Nordic-Energy/HalfBridgePowerModule/mechanical/3D view.PNG

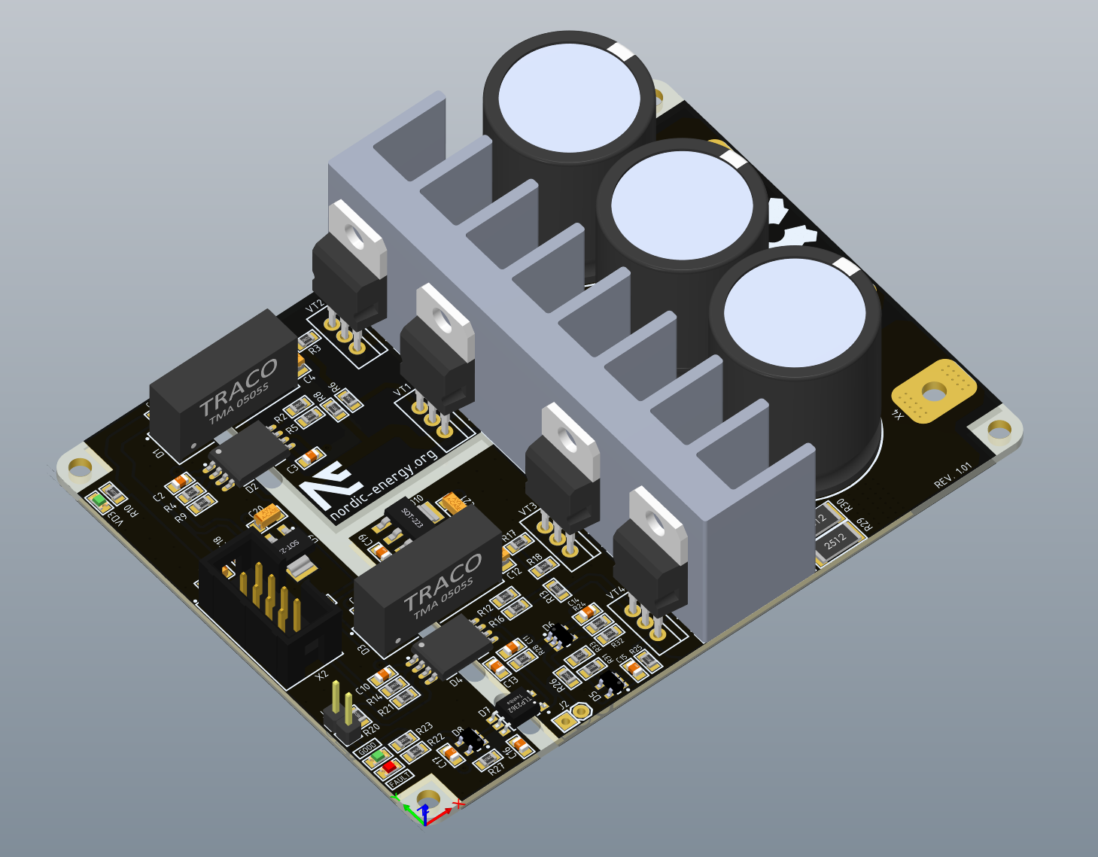
mechanical/3D view.PNG
