Nordic-Energy/HalfBridgePowerModule/docs/BOM for half-brudge module.xlsx

Value | Designator | Manufacturer | Model | Quantity
1μF | C1, C3, C6, C11, C18, C19 | Yageo | CC0805KKX7R7BB105 | 6
0.1μF | C2, C10, C14, C16, C17 | Yageo | CC0805KRX7R7BB104 | 5
4.7μF | C4, C5, C12 | KEMET | T494A475M025AT | 3
680μF | C7, C8, C9 | Yageo | LG100M0680BPF-2225 | 3
100pF | C13, C15 | Yageo | CC0805KRNPO9BN101 | 2
33μF | C20, C21 | AVX | TPSA336K010R0700 | 2
 | D1, D3 | Mornsun | B1212S-2W | 2
 | D2, D4 | Infineon | 1EDC60I12AHXUMA1 | 2
 | D5 | Texas Instruments | LMV611MFX/NOPB | 1
 | D6 | Texas Instruments | TLV3491AIDBVR | 1
 | D7 | Toshiba | TLP2362 | 1
 | D8 | Texas Instruments | SN74LVC1G14DBVRG4 | 1
 | D9 | Diodes | AZ1117IH-3.3TRG1 | 1
 | D10 | Diodes | AZ1117IH-5.0TRG1 | 1
 | J1, J2 | Connfly | PLS-2 | 2
10k | R1, R8, R9, R10, R11, R18, R20, R21 | Yageo | RC0805JR-0710KL | 8
1R | R2, R3, R6, R12, R13, R17 | Yageo | RC0805JR-071RL | 6
100R | R4, R7, R14, R26, R28 | Yageo | RC0805JR-07100RL | 5
1R8 | R5, R16 | Yageo | RC0805JR-071R8L | 2
100k | R15, R19 | Yageo | RC1206JR-07100KL | 2
1k | R22, R23, R25 | Yageo | RC0805JR-071KL | 3
1k | R24, R33 | Yageo | RC0805FR-071KL | 2
4k7 | R27 | Yageo | RC0805JR-074K7L | 1
0R004 | R29, R30 | Yageo | PA2512FKF7W0R004E | 2
100k | R31 | Yageo | RC0805FR-07100KL | 1
10k | R32 | Yageo | RC0805FR-0710KL | 1
 | VD1, VD2, VD3, VD5 | Wurth | 150080VS75000 | 4
 | VD4 | Wurth | 150080RS75000 | 1
 | VT1, VT2, VT3, VT4 | Infineon | IPP083N10N5AKSA1 | 4
 | X2 | Connfly | IDC-10M | 1
