Nordic-Energy/HalfBridgePowerModule/docs/Schematics for half-bridge module.pdf

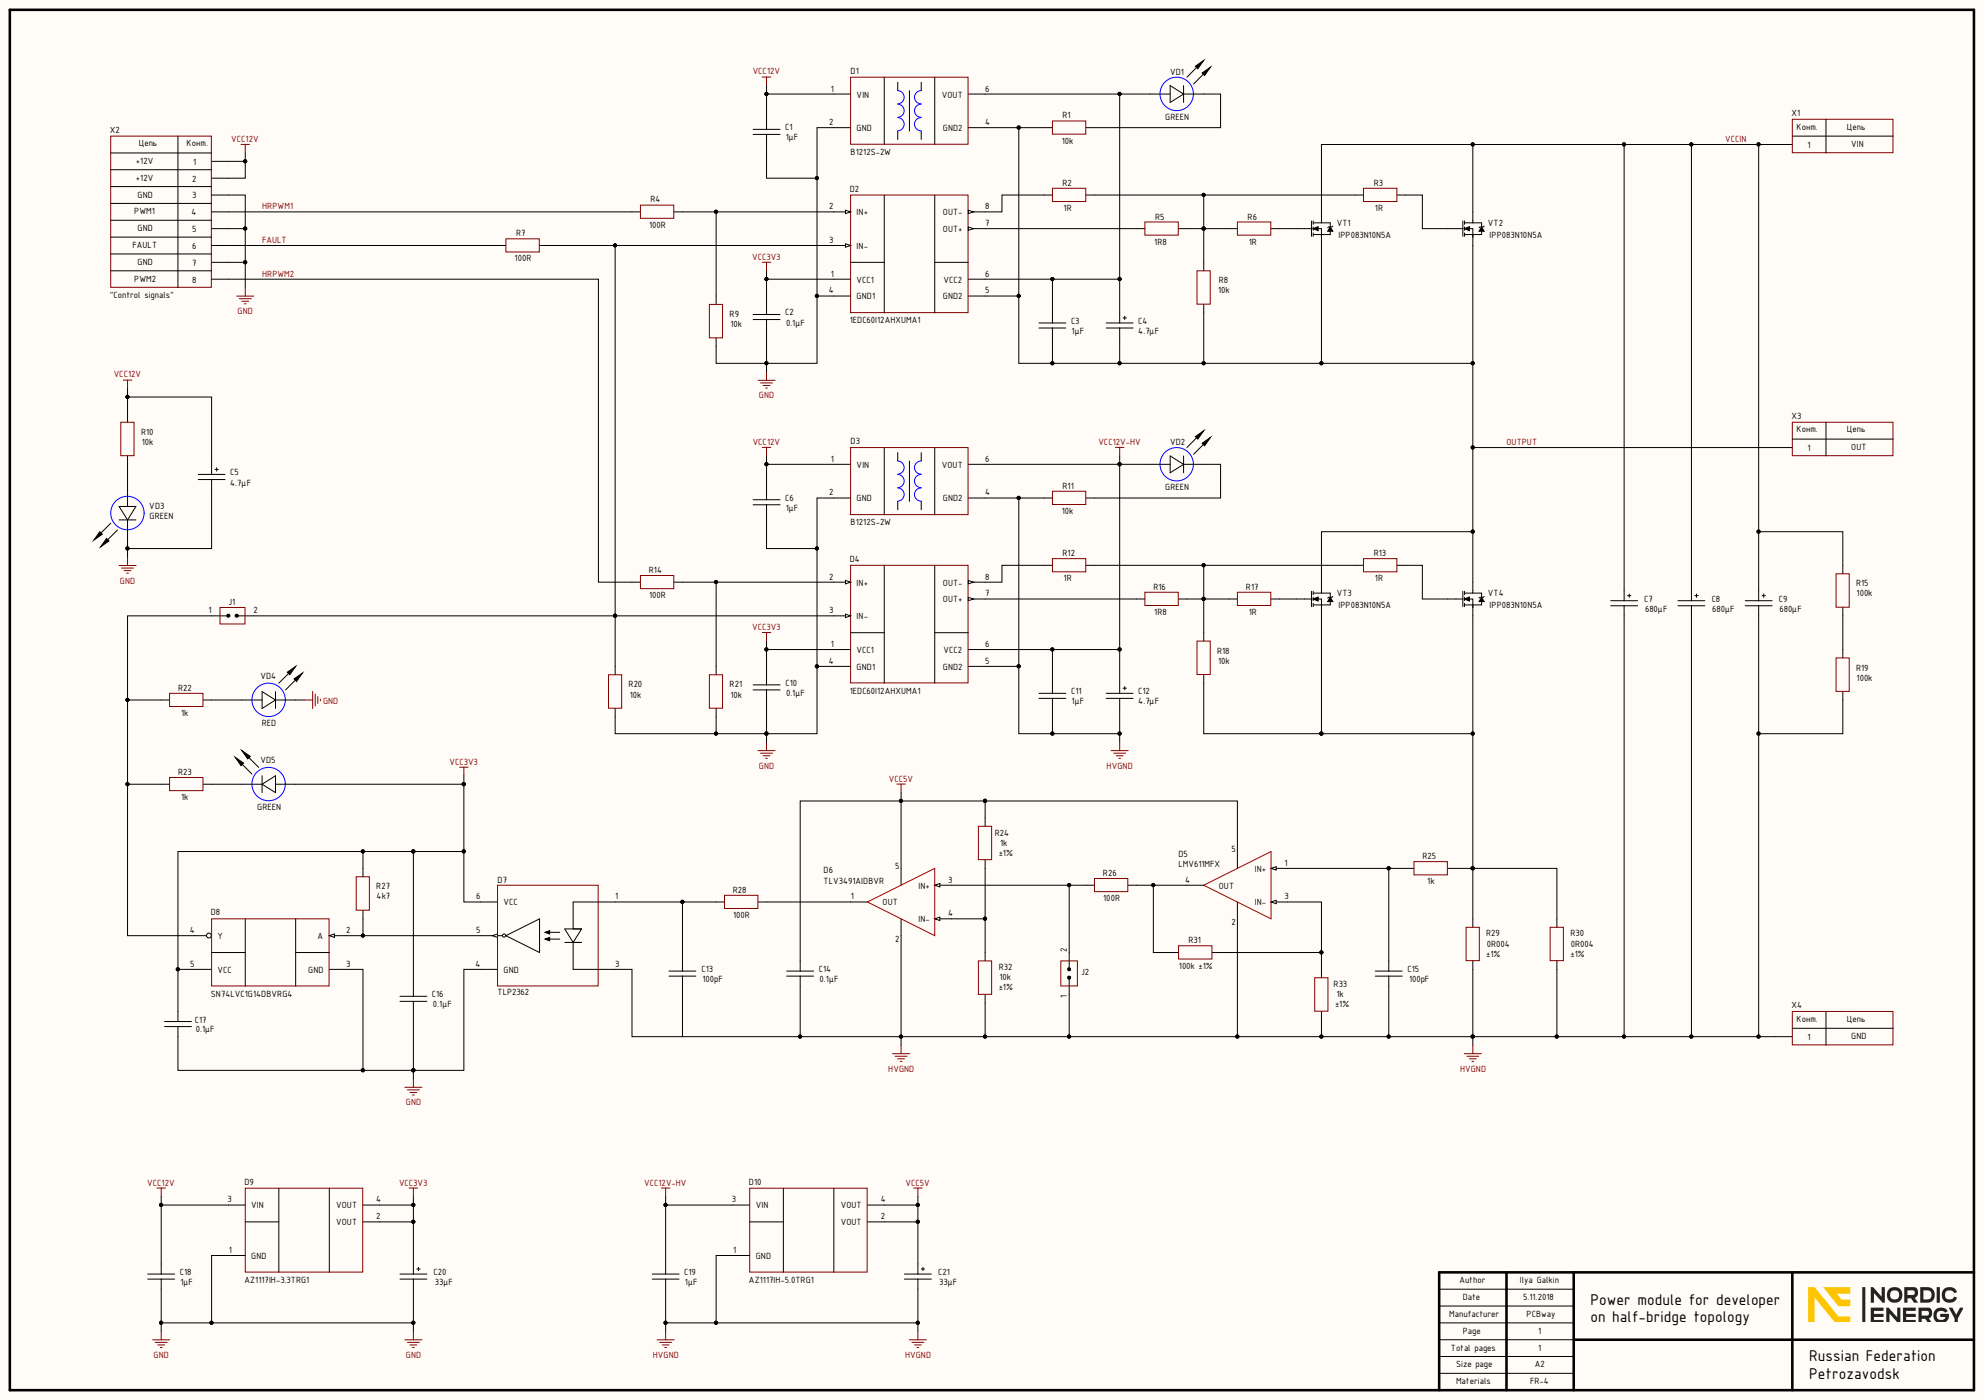
[picture p2: page 1]

R1 | GREEN

Конт. | Цепь

GND | 3

HRPWM2 | VCC3V3 | VCC1 1

GND | 7 | 100R

PWM2 | 8

GND C5 4.7μF

1 | OUT

1 | GND

Author | Ilya Galkin | Power module for developer on half-bridge topology

Date | 5.11.2018

Manufacturer | PCBway

Total pages | 1 | Russian Federation Petrozavodsk Materials

Size page | A2

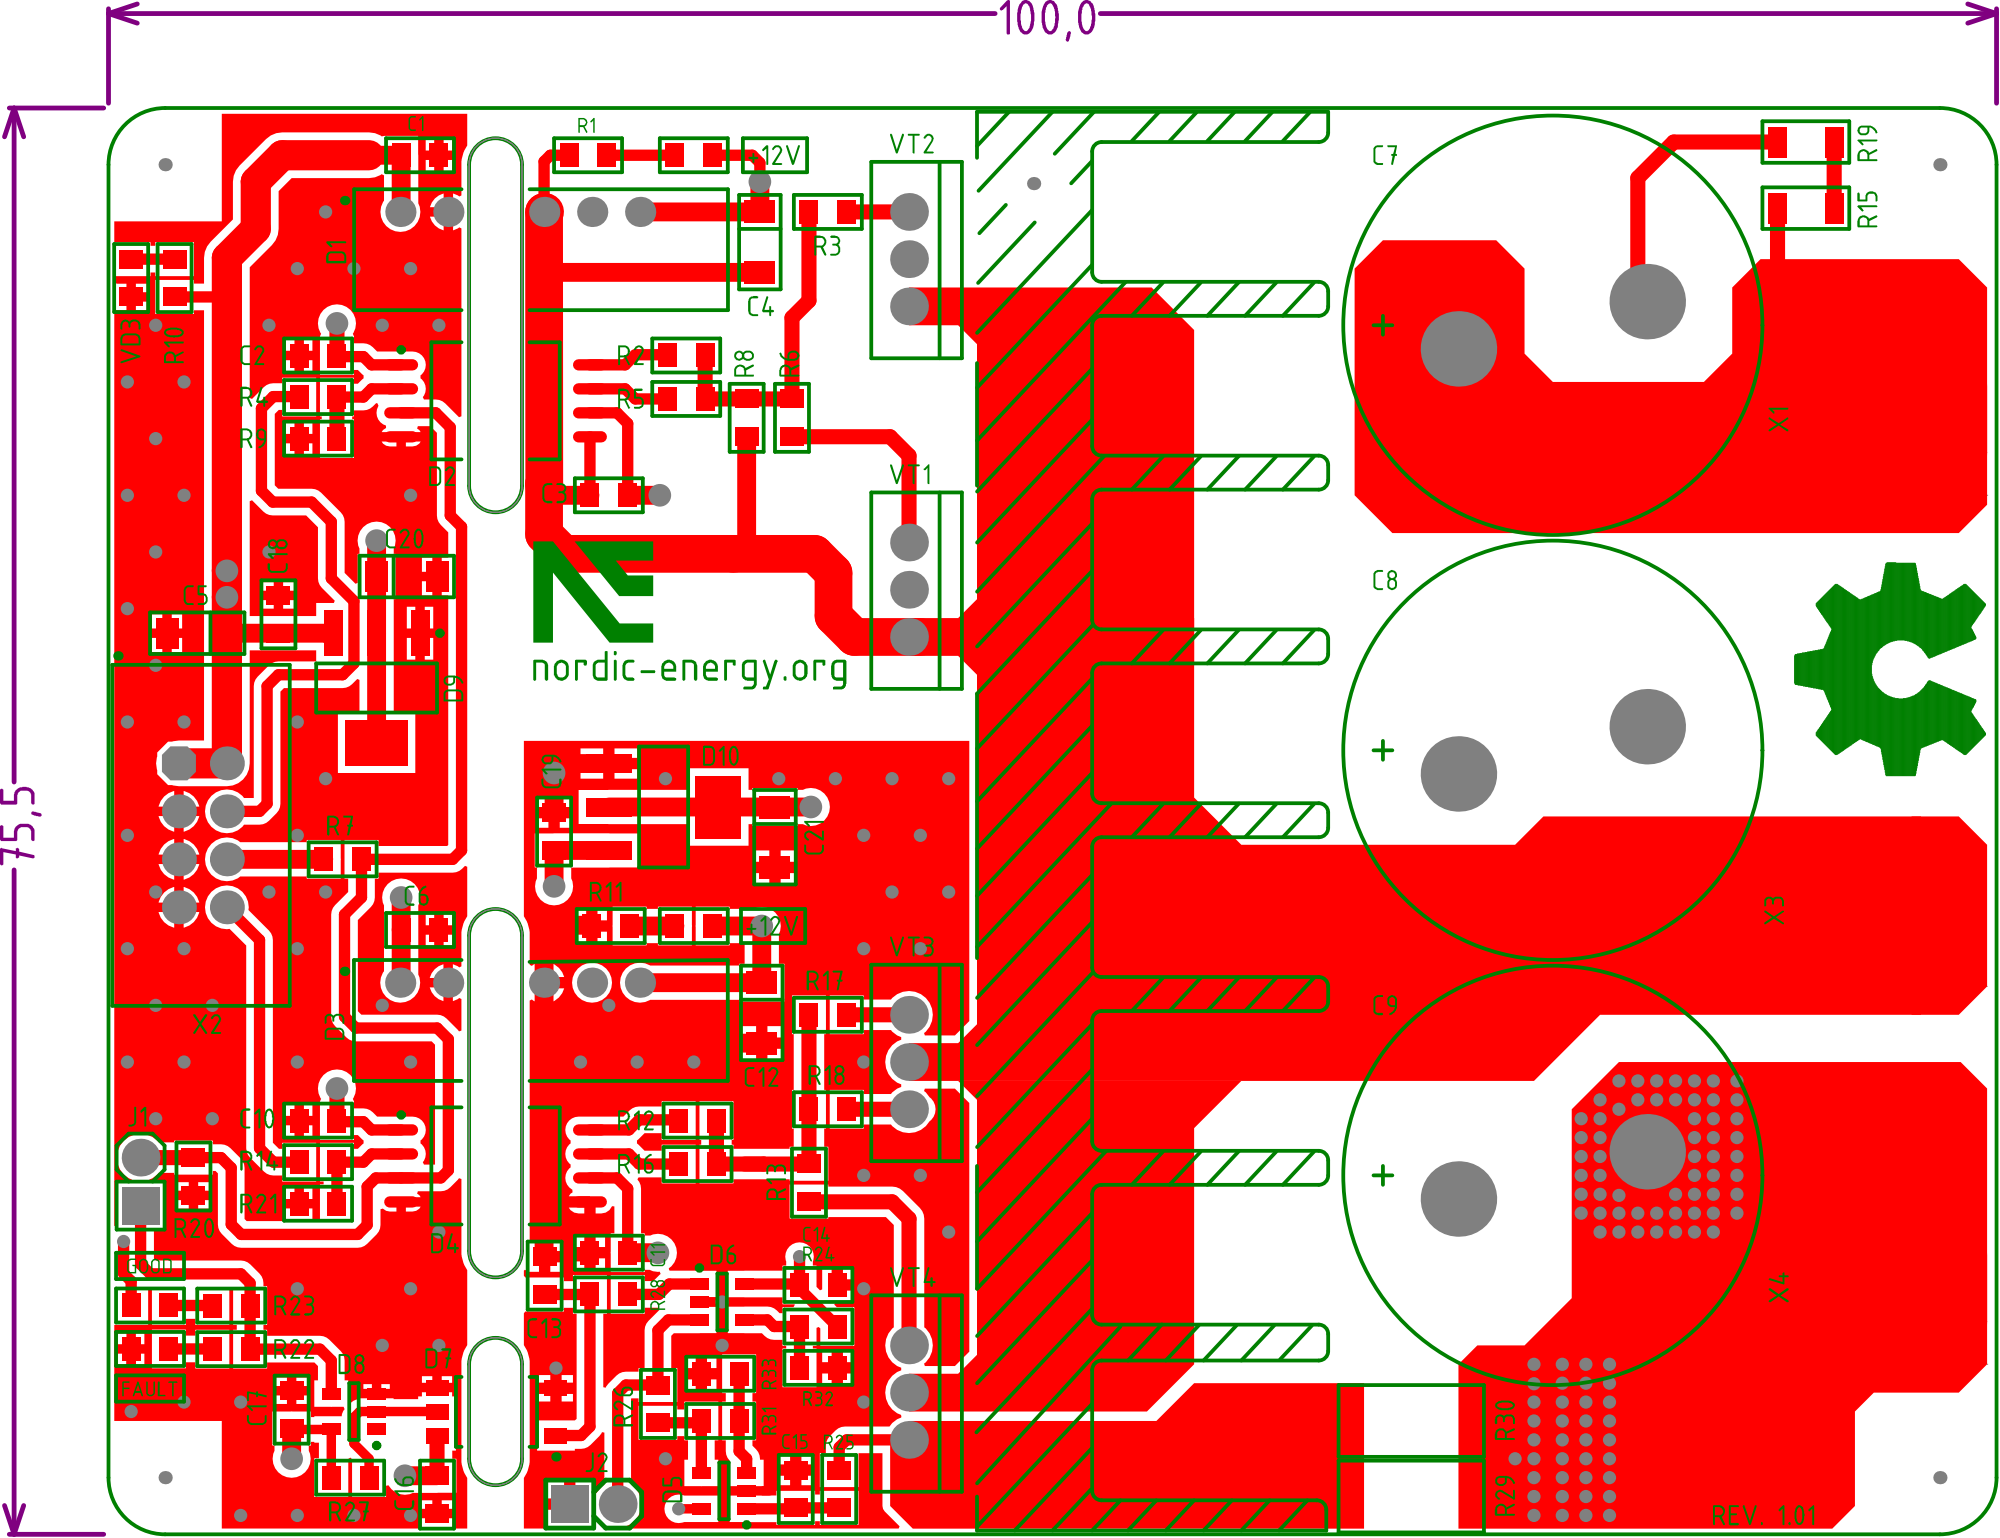
[picture p3: page 2]

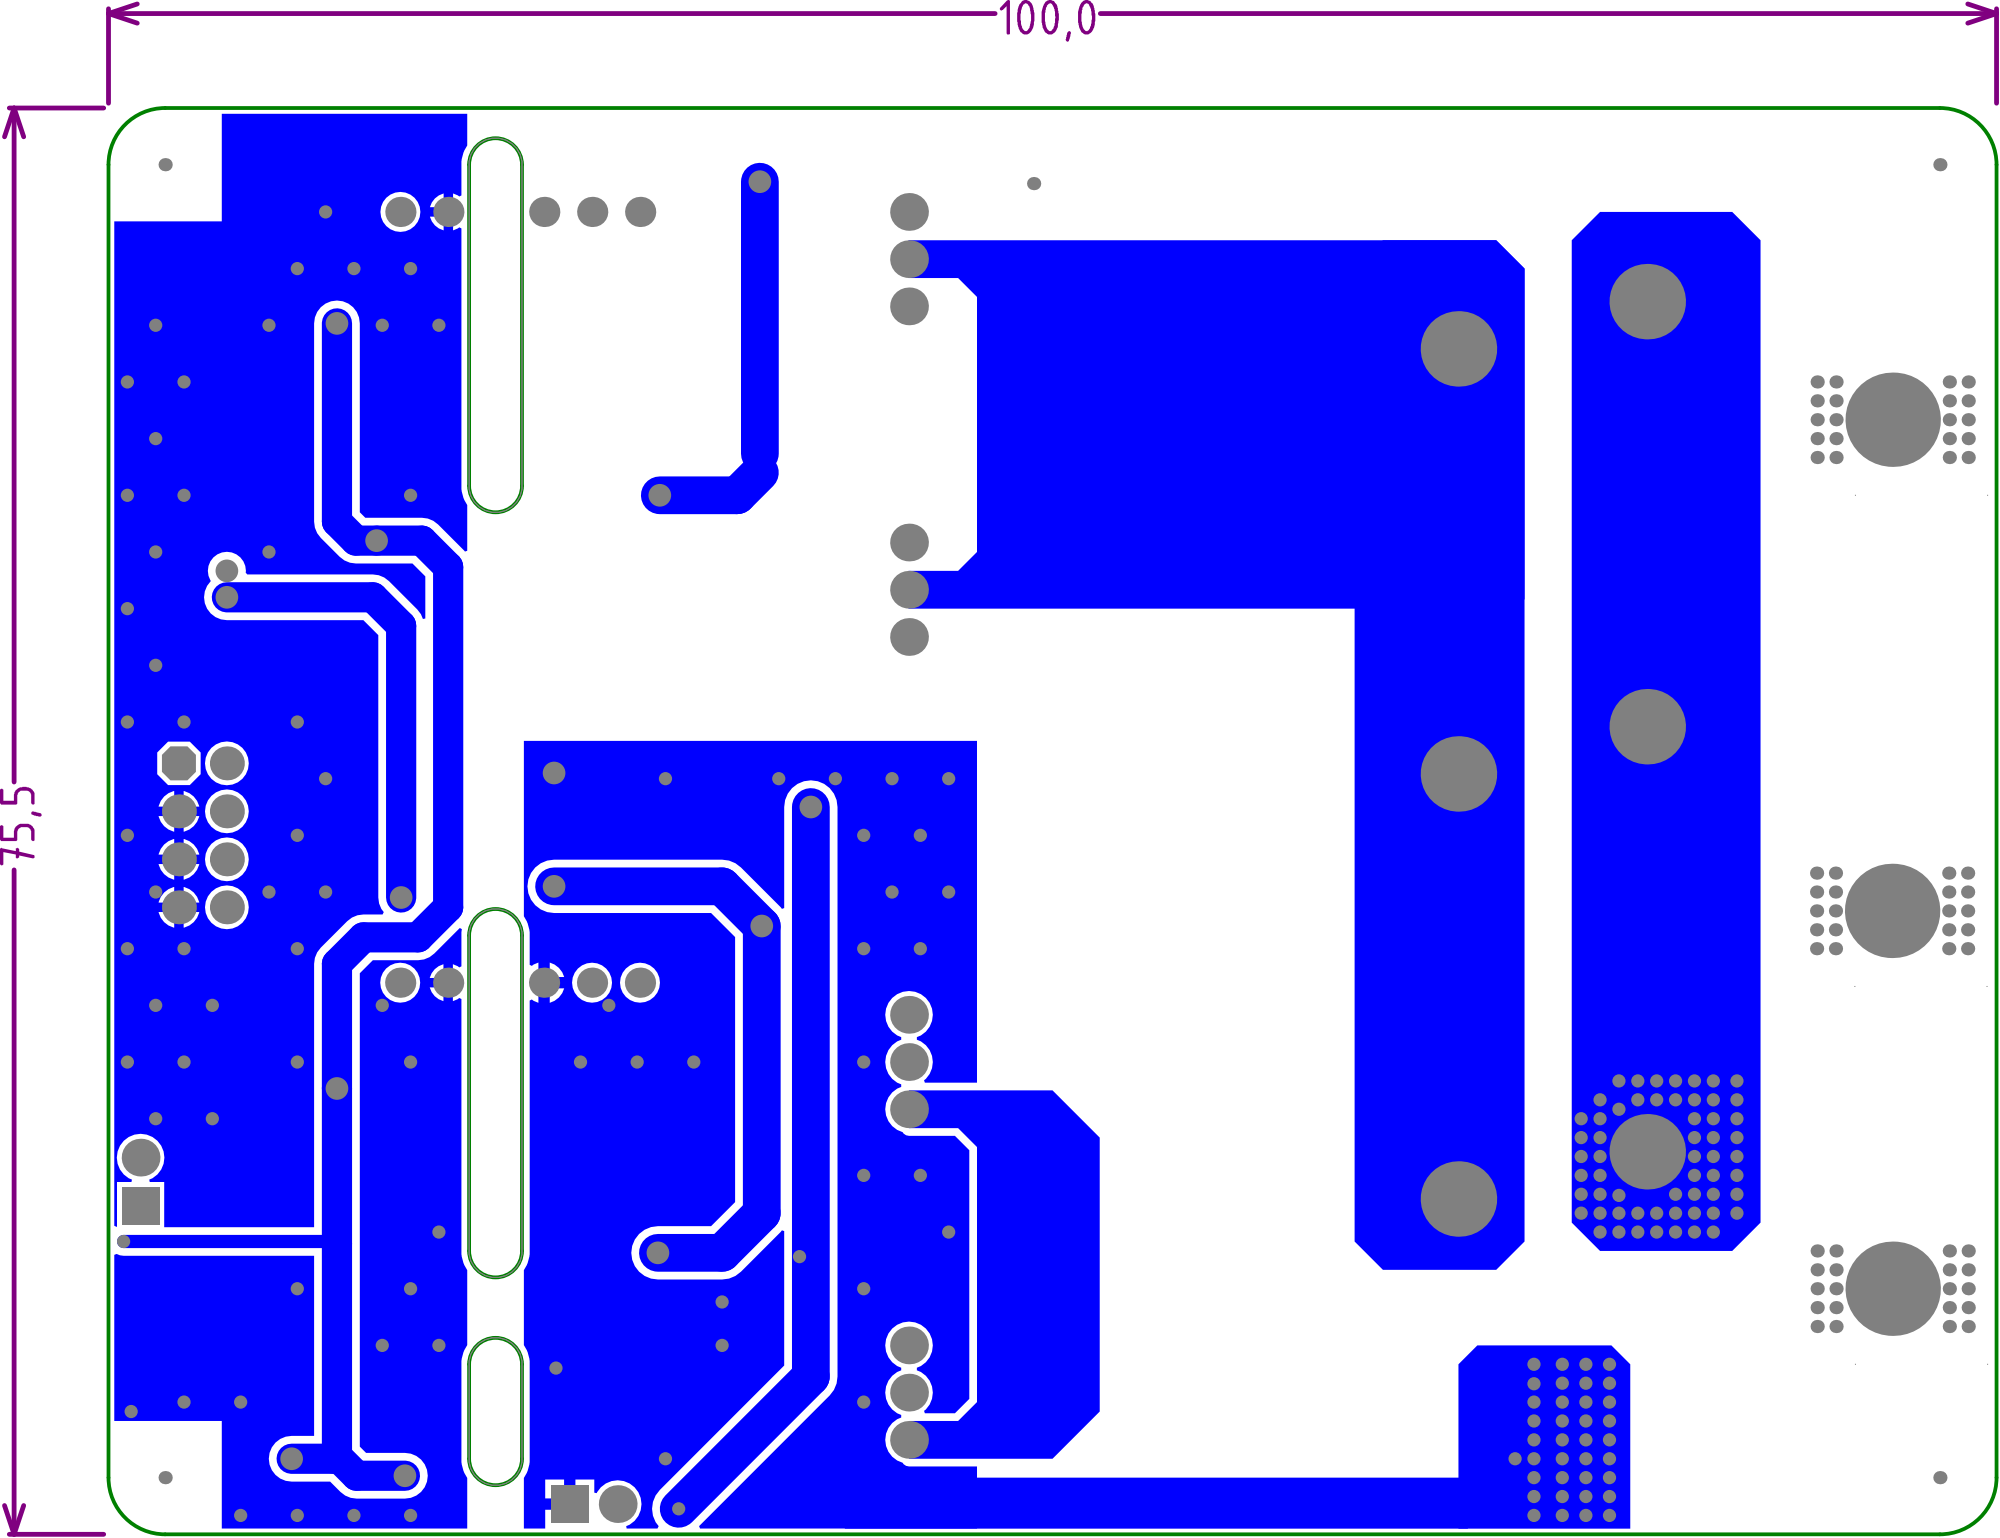
[picture p4: page 3]
