Nordic-Energy/HalfBridgePowerModule/(list of files, drawings)

Other design files:
project/Half-bridge module.PrjPcb
project/Page 1.SchDoc
