Nordic-Energy/HalfBridgePowerModule/(commit log)

2019-05-30 git init
    [BOM for half-brudge module.xlsx, Half-bridge module.PrjPcb, Page 1.SchDoc]
2020-03-28 docs: Обновил описание проекта и инструментов в readme
2020-08-15 refactor: Изменил имена папок и структуру репозитория на стандартный
    [BOM for half-brudge module.xlsx, Half-bridge module.PrjPcb, Page 1.SchDoc]
